realA10001986/Doc-s-Stopwatches/Electronics/Citizen/BOM_Citizen_2026-06-30.csv

ID | Name | Designator | Footprint | Quantity | Manufacturer Part | Manufacturer | Supplier | Supplier Part | Price
1 | QSOP-24_L8.7-W3.9-P0.64-LS6.0-BL | U2 | QSOP-24_L8.7-W3.9-P0.64-LS6.0-BL | 1 | AS1115-BSST | AMS | LCSC | C2649434 | 4.974
2 | R0603 | R8,R6,R7 | R0603 | 3 | 0603WAF1002T5E | UNI-ROYAL(厚声) | LCSC | C25804 | 0.002
3 | R0603 | R5 | R0603 | 1 | 0603WAF1302T5E | UNI-ROYAL(厚声) | LCSC | C22797 | 0.002
4 | C0805 | C19 | C0805 | 1 | CL21A106KAYNNNE | SAMSUNG(三星) | LCSC | C15850 | 0.221
5 | C0603 | C15,C20 | C0603 | 2 | CC0603KRX7R9BB104 | YAGEO(国巨) | LCSC | C14663 | 0.013
6 | TQFP-32_L7.0-W7.0-P0.80-LS9.0-BL | U1 | TQFP-32_L7.0-W7.0-P0.80-LS9.0-BL | 1 | ATMEGA328PB-ANR | MICROCHIP(美国微芯) | LCSC | C2053137 | 3.383
